AlejandroValle99/Comunicaci-n-Subacu-tica/README.md

Proyecto de tesis de graduacion desarrollando un sistema de comunicacion subacuatica implementando conocimientos de ingeniería de control, electrónica, programación para poder enviar y recibir datos abajo del agua inalambricamente entre emisor y receptor.

Se utilizó modulación y demodulación FSK construyendo placas electronicas, programación C para PIC para lectura de sensores y acondicionamiento de señales, moduladores y demoduladores, transductor piezoeléctrico para envío de señal e hidrófono para la recepción.
