AlejandroValle99/Comunicaci-n-Subacu-tica/Proteus/Amplificador/Amplificador.PDF

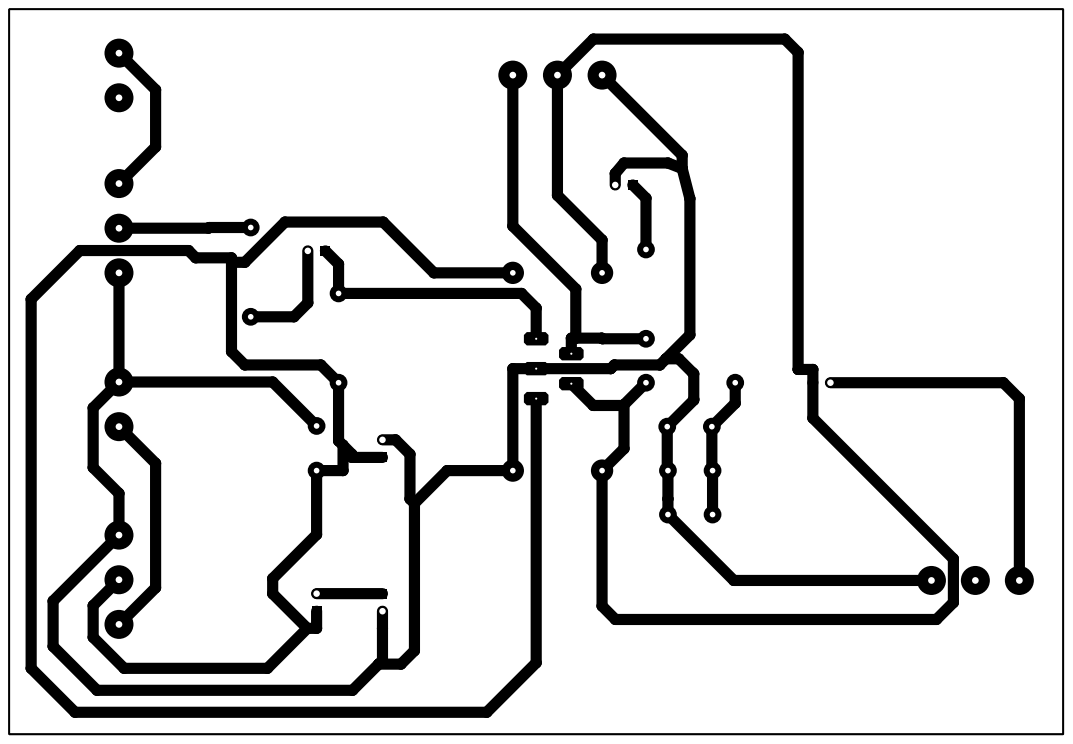
[picture p20: page 1]
