AlejandroValle99/Comunicaci-n-Subacu-tica/Proteus/Emisor/Emisor.PDF

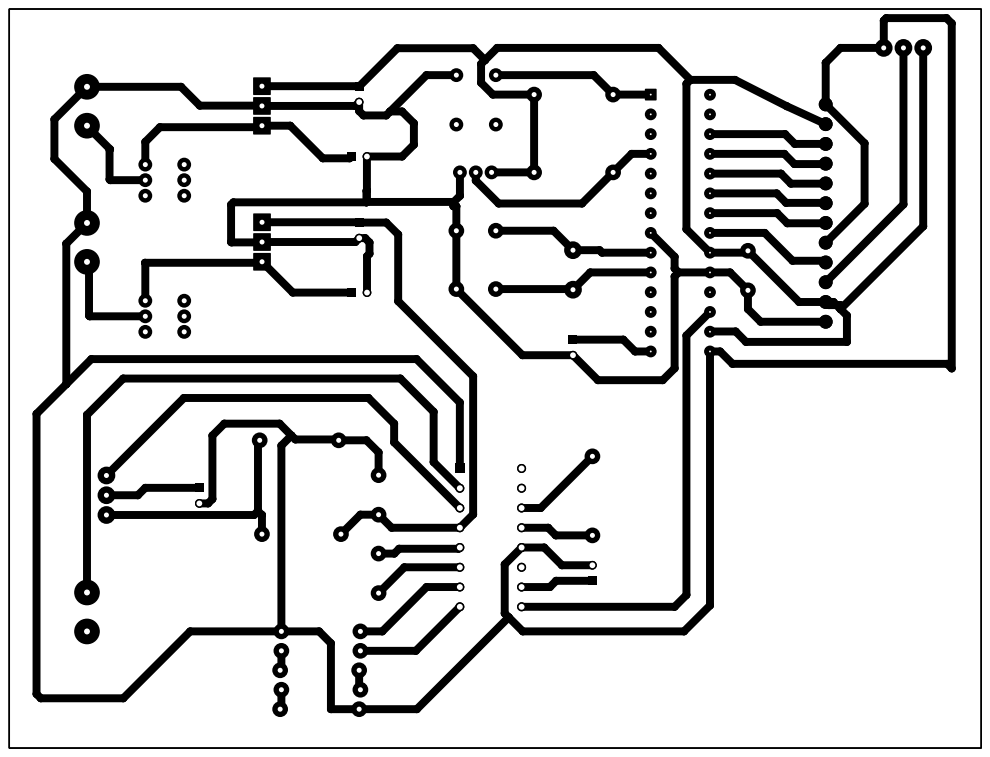
[picture p21: page 1]
