AlejandroValle99/Comunicaci-n-Subacu-tica/Proteus/Receptor/Receptor.PDF

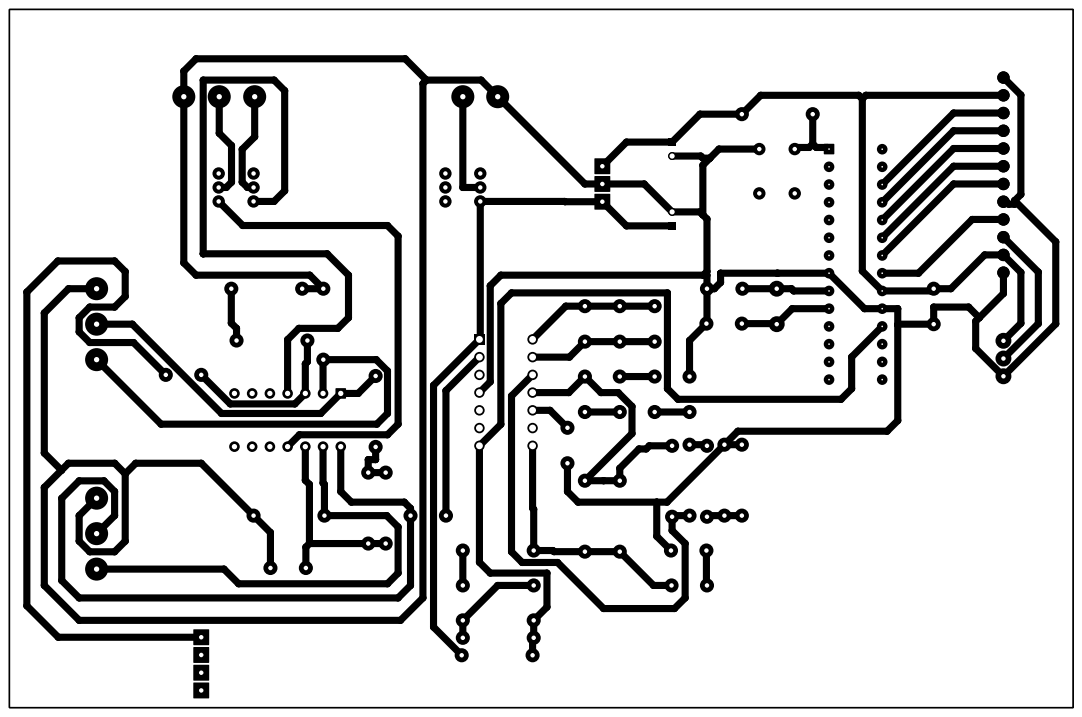
[picture p22: page 1]
