AlejandroValle99/Comunicaci-n-Subacu-tica/(list of files, drawings)

Other design files:
Multisim/amplificador de potencia final.ms14
Multisim/filtro pasabanda dual lm324.ms14
Proteus/Amplificador/Amplificador.pdsprj
Proteus/Amplificador/Project Backups/Amplificador [20211213, 20-17-26].pdsprj
Proteus/Amplificador/Project Backups/Amplificador [20211215, 15-52-54].pdsprj
Proteus/Amplificador/Project Backups/Amplificador [20211219, 17-48-58].pdsprj
Proteus/Amplificador/Project Backups/Amplificador [20211219, 17-50-31].pdsprj
Proteus/Amplificador/Project Backups/Amplificador [20211219, 17-50-44].pdsprj
Proteus/Amplificador/Project Backups/Amplificador [20211219, 17-51-10].pdsprj
Proteus/Amplificador/Project Backups/Amplificador [20211219, 19-00-58].pdsprj
Proteus/Amplificador/Project Backups/Amplificador [20211220, 15-05-48].pdsprj
Proteus/Amplificador/Project Backups/Amplificador [20211220, 17-50-42].pdsprj
Proteus/Amplificador/Project Backups/Amplificador [20220102, 22-08-48].pdsprj
Proteus/Emisor/Emisor.pdsprj
Proteus/Emisor/Project Backups/Emisor [20211210, 14-15-09].pdsprj
Proteus/Emisor/Project Backups/Emisor [20211210, 14-15-27].pdsprj
Proteus/Emisor/Project Backups/Emisor [20211214, 16-22-16].pdsprj
Proteus/Emisor/Project Backups/Emisor [20211219, 22-53-40].pdsprj
Proteus/Emisor/Project Backups/Emisor [20220102, 15-31-49].pdsprj
Proteus/Emisor/Project Backups/Emisor [20220102, 15-34-03].pdsprj
Proteus/Emisor/Project Backups/Emisor [20220102, 16-57-22].pdsprj
Proteus/Emisor/Project Backups/Emisor [20220102, 16-57-24].pdsprj
Proteus/Emisor/Project Backups/Emisor [20220102, 21-53-55].pdsprj
Proteus/Emisor/Project Backups/Emisor [20220102, 23-20-42].pdsprj
Proteus/Project Backups/Fase1 [20211112, 11-56-25].pdsprj
Proteus/Project Backups/Fase1 [20211112, 11-56-31].pdsprj
Proteus/Project Backups/Fase1 [20211112, 11-58-21].pdsprj
Proteus/Project Backups/Fase1 [20211112, 14-36-27].pdsprj
Proteus/Project Backups/Fase1 [20211112, 17-38-35].pdsprj
Proteus/Project Backups/Fase1 [20211112, 22-21-26].pdsprj
Proteus/Project Backups/Fase1 [20211114, 23-30-38].pdsprj
Proteus/Project Backups/Fase1 [20211123, 17-54-50].pdsprj
Proteus/Project Backups/Fase1 [20211219, 23-10-53].pdsprj
Proteus/Project Backups/Fase1 [20211219, 23-45-59].pdsprj
Proteus/Receptor/Project Backups/Receptor [20211216, 17-34-12].pdsprj
Proteus/Receptor/Project Backups/Receptor [20211216, 17-49-37].pdsprj
Proteus/Receptor/Project Backups/Receptor [20211216, 18-55-27].pdsprj
Proteus/Receptor/Project Backups/Receptor [20211216, 18-57-35].pdsprj
Proteus/Receptor/Project Backups/Receptor [20211216, 23-40-04].pdsprj
Proteus/Receptor/Project Backups/Receptor [20211216, 23-41-33].pdsprj
Proteus/Receptor/Project Backups/Receptor [20211218, 00-17-35].pdsprj
Proteus/Receptor/Project Backups/Receptor [20211218, 13-23-01].pdsprj
Proteus/Receptor/Project Backups/Receptor [20220102, 16-50-55].pdsprj
Proteus/Receptor/Project Backups/Receptor [20220102, 22-49-56].pdsprj
Proteus/Receptor/Receptor.pdsprj
Proteus/Simulación Tx_Rx.pdsprj
